dm5tt/MeshtasticNode_BQ25185/components/steps/BH_18650_PC/BH-18650-PC.step

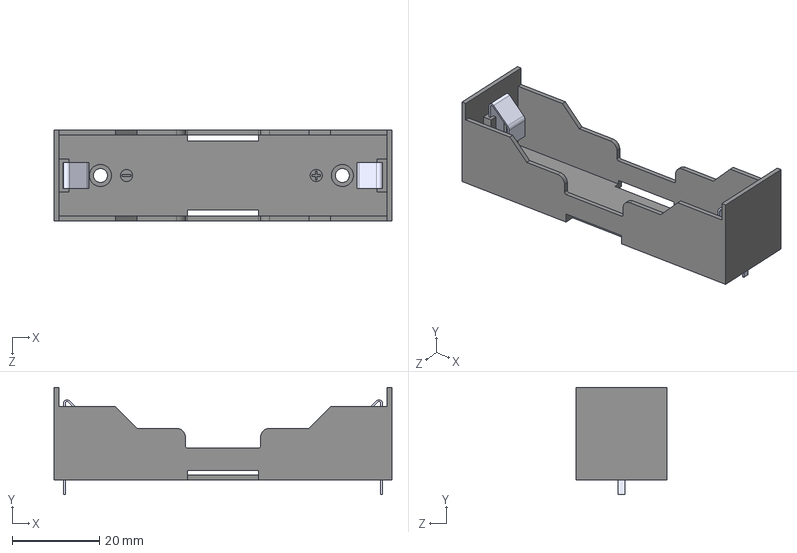
[picture p2: CAD file, 2024-08-03]
components/steps/BH_18650_PC/BH-18650-PC.step
77.7 x 24.6 x 20.9 mm
