dm5tt/MeshtasticNode_BQ25185/MeshtasticNode_BQ25185.pdf

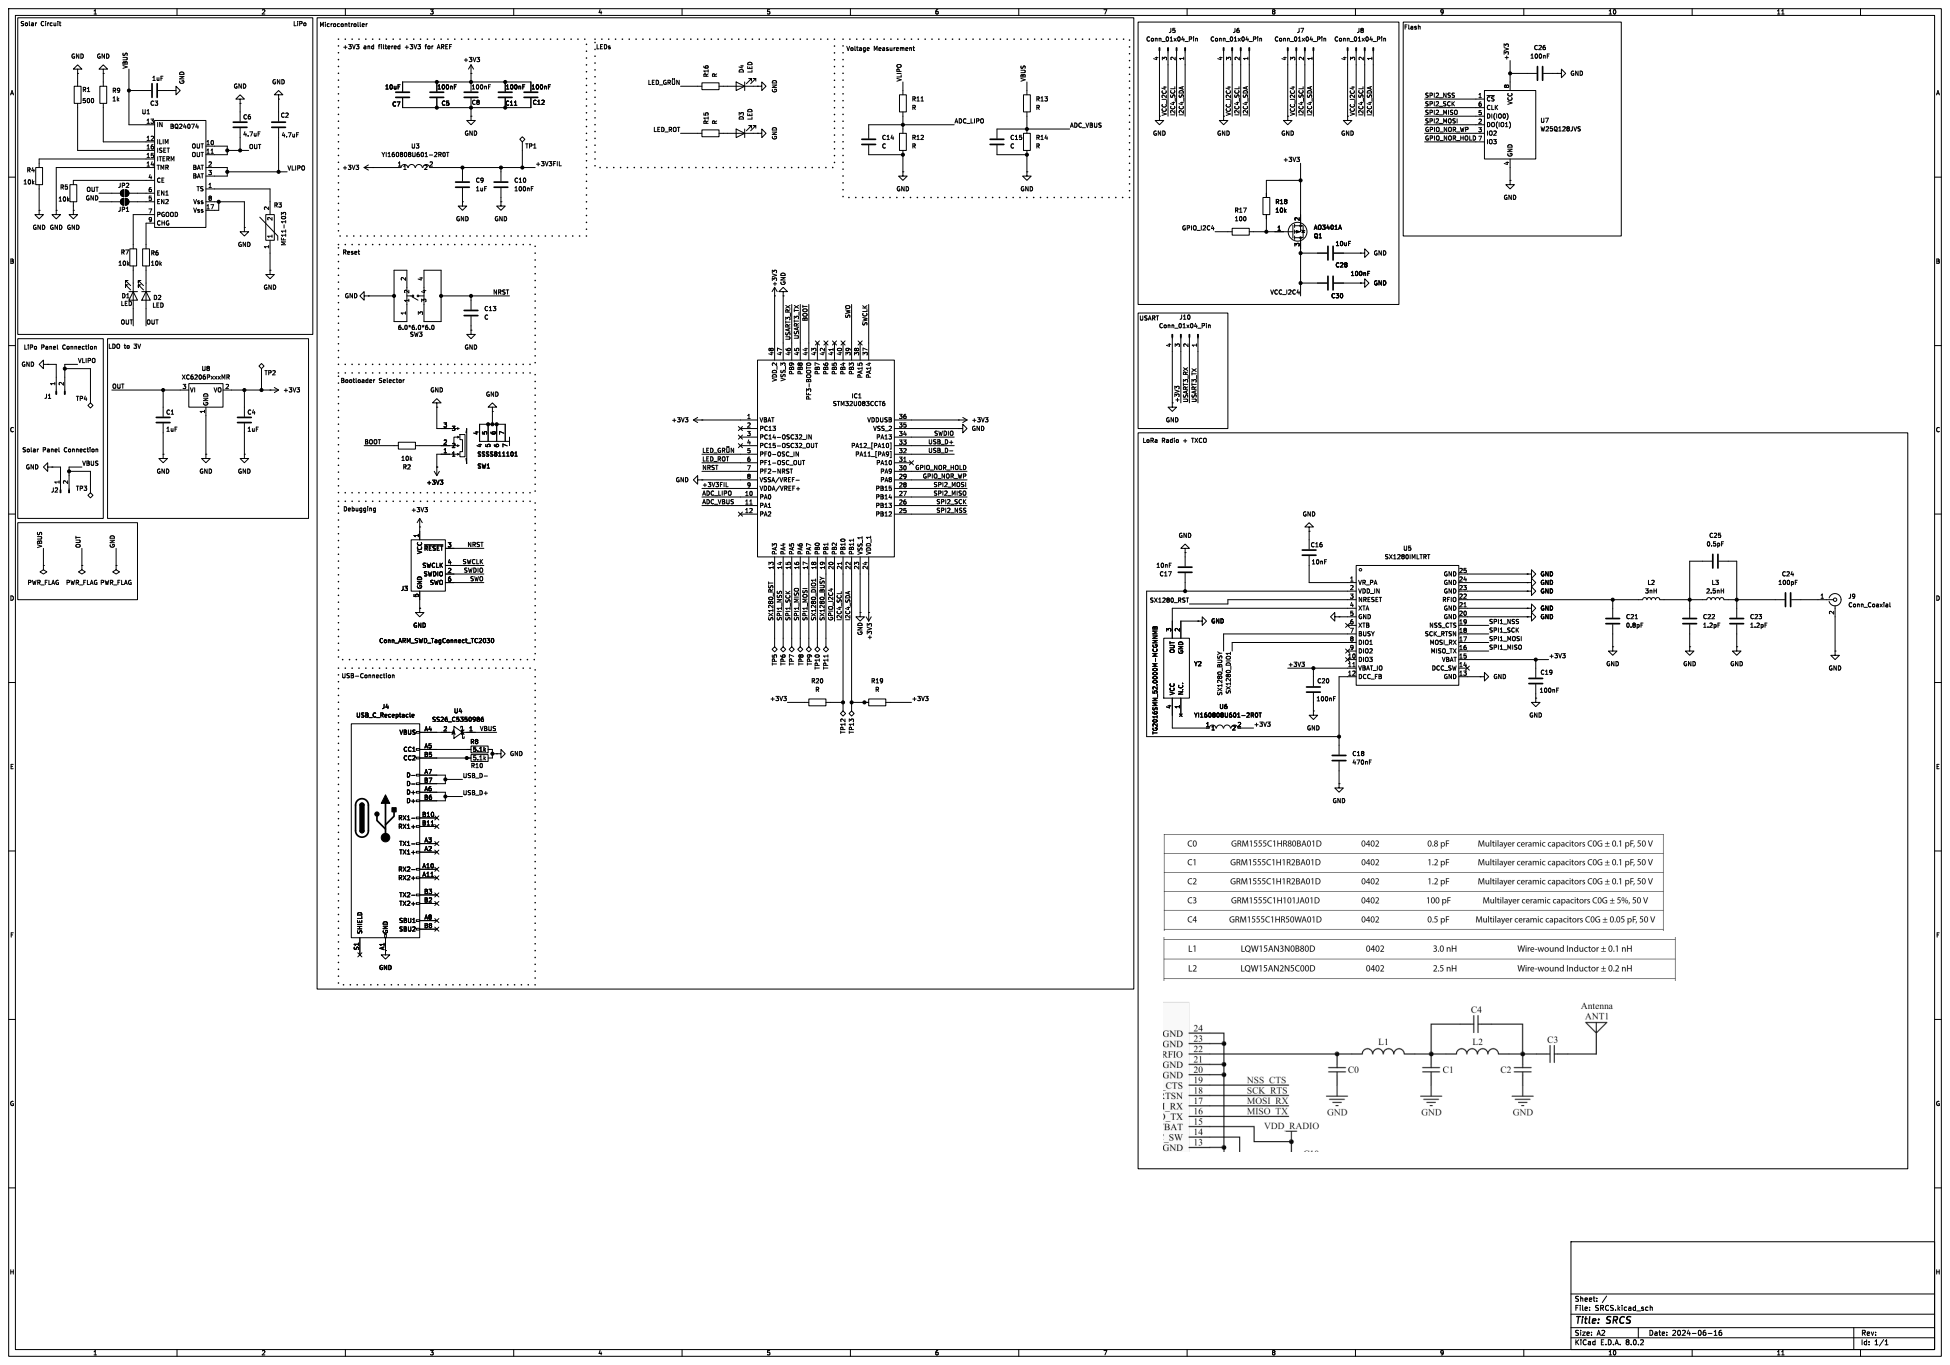
[picture p3: page 1]

1 SWDIO 2 ~{RESET}3 SWCLK 4 GND
