dm5tt/MeshtasticNode_BQ25185/(threads)

Thread 1 (2024-09-21):

If power supply of the LDO drops too low it collapes immediately - too fast for the Brown-Out-Detection to trigger

dm5tt, 2024-09-21:
If the power supply of  3.3V LDO after the BQ25185 drops below ~3.4V it collapses almost immediately. The ESP32 brown-out-detection is too slow to react. This can and will cause file system corruption during early boot phases of the Meshtastic firmware if this happen during a write.

**Solution**

Add a Reset-IC before the LDO (as this is the Solar+LiPo voltage mix) and disable EN if we are dropping too low.

dm5tt, 2024-10-14:
I think this problem can easily be solved: Replace the 3V3  with a 3V0 LDO so the entire device can stay alive much longer. With the the "Low Power" detection of Meshtastic (that uses the ADC) can safely put the ESP32 into a safe deep sleep mode.

dm5tt, 2024-10-27:
Fixed with V1.0

Thread 3 (2025-01-17):

Reset IC triggers  too often around 3.2V

dm5tt, 2025-01-17:
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

Potential solutions:

1. Get a different Reset IC that waits for 1-2 seconds
2. Add a C to buffer the voltage
3. Add a proper filter

Testing solution 2. now.

dm5tt, 2025-01-18:
Added a 1uF capacitor directly next to the Reset-IC Vcc and its GND. Test running.

dm5tt, 2025-01-20:
Temporary fix in v2.0.1

Closed 2025-01-20.
