dm5tt/MeshtasticNode_BQ25185/(commit log)

2024-08-02 pcb: smaller design cleanuo
    [MeshtasticNode_BQ25185.kicad_pcb, MeshtasticNode_BQ25185.kicad_sch]
2024-08-02 pcb: increase version
    [MeshtasticNode_BQ25185.kicad_pcb]
2024-08-03 pcb: Prepare for V2
    [BH-18650-PC.step, MeshtasticNode_BQ25185.kicad_pcb, MeshtasticNode_BQ25185.kicad_sch]
2024-08-03 pcb: smaller fine tunings
    [MeshtasticNode_BQ25185.kicad_pcb]
2024-08-03 pcb: move ntc a bit higher
    [MeshtasticNode_BQ25185.kicad_pcb]
2024-08-05 pcb: widen powerlanes
    [MeshtasticNode_BQ25185.kicad_pcb, MeshtasticNode_BQ25185.kicad_sch]
2024-08-06 pcb: add transistor to LEDs as we only have 1.8V
    [MeshtasticNode_BQ25185.kicad_pcb, MeshtasticNode_BQ25185.kicad_sch]
2024-08-06 pcb: replace picture
